jzimme14/ESP32-C3-custom-test-board/ASCKCF00-AP5R5010402/3D/ASCKCF00-AP5R5010402.stp

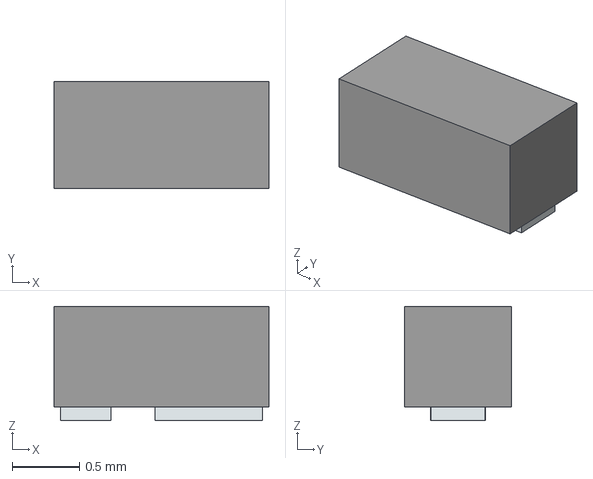
[picture p1: CAD file, 2024-05-04]
ASCKCF00-AP5R5010402/3D/ASCKCF00-AP5R5010402.stp
1.60 x 0.8 x 0.85 mm
Pins
