jzimme14/ESP32-C3-custom-test-board/BME280/3D/BME280.stp

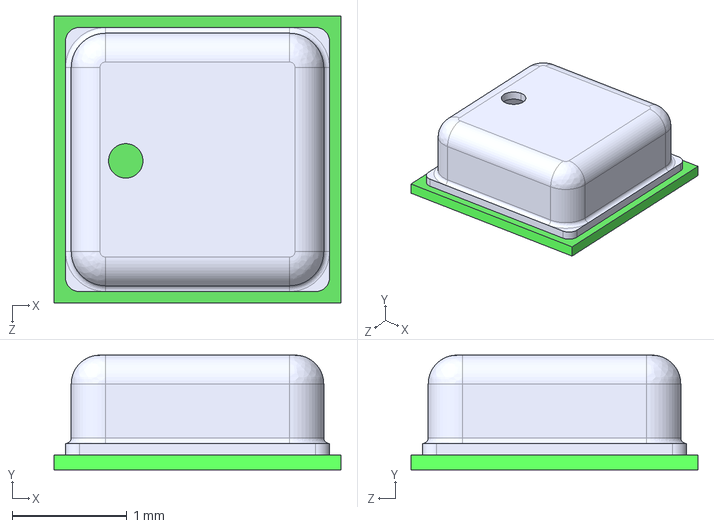
[picture p2: CAD file, 2024-05-04]
BME280/3D/BME280.stp
2.50 x 1.00 x 2.50 mm
