jzimme14/ESP32-C3-custom-test-board/ESP32-C3/3D/ESP32-C3.stp

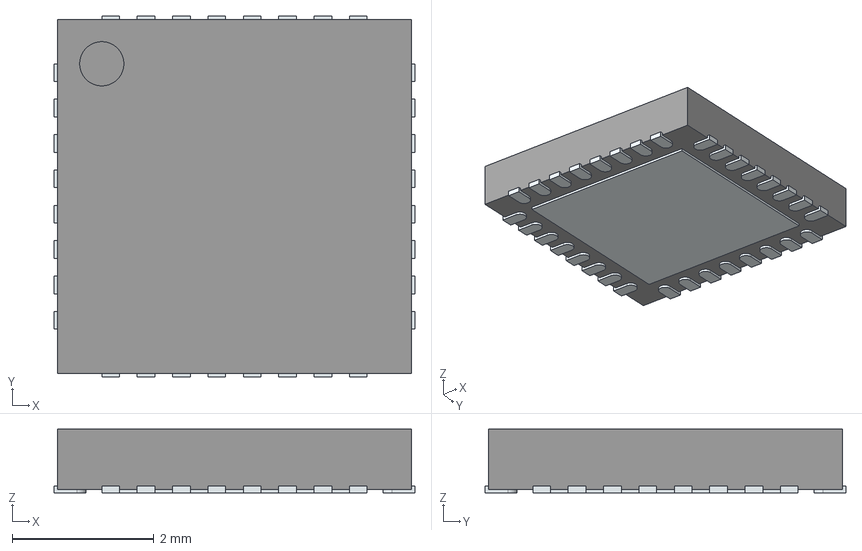
[picture p3: CAD file, 2024-05-03]
ESP32-C3/3D/ESP32-C3.stp
5.10 x 5.10 x 0.9 mm
ThermalPin
PinsArrayLR
PinsArrayTB
