jzimme14/ESP32-C3-custom-test-board/GD25Q16CTEGR/3D/GD25Q16CTEGR.stp

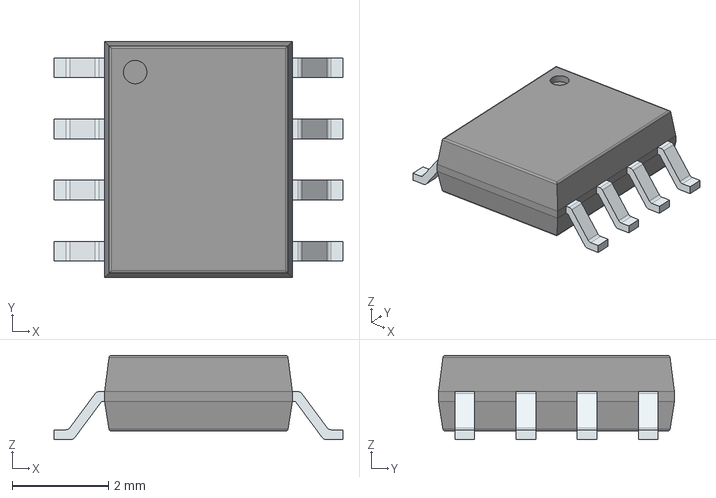
[picture p4: CAD file, 2024-05-03]
GD25Q16CTEGR/3D/GD25Q16CTEGR.stp
6.00 x 4.90 x 1.75 mm
PinsArrayLR
