jzimme14/ESP32-C3-custom-test-board/GSB1C41110SSHR/3D/GSB1C41110SSHR.stp

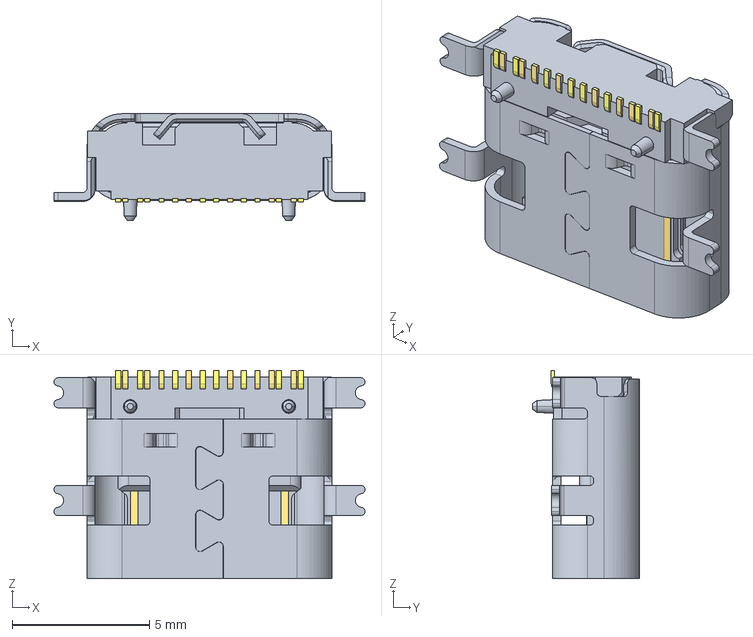
[picture p5: CAD file, 2024-05-03]
GSB1C41110SSHR/3D/GSB1C41110SSHR.stp
11.3 x 3.89 x 7.60 mm
