jzimme14/ESP32-C3-custom-test-board/SMD_IC_SY8089AAAC/3D/SMD_IC_SY8089AAAC.stp

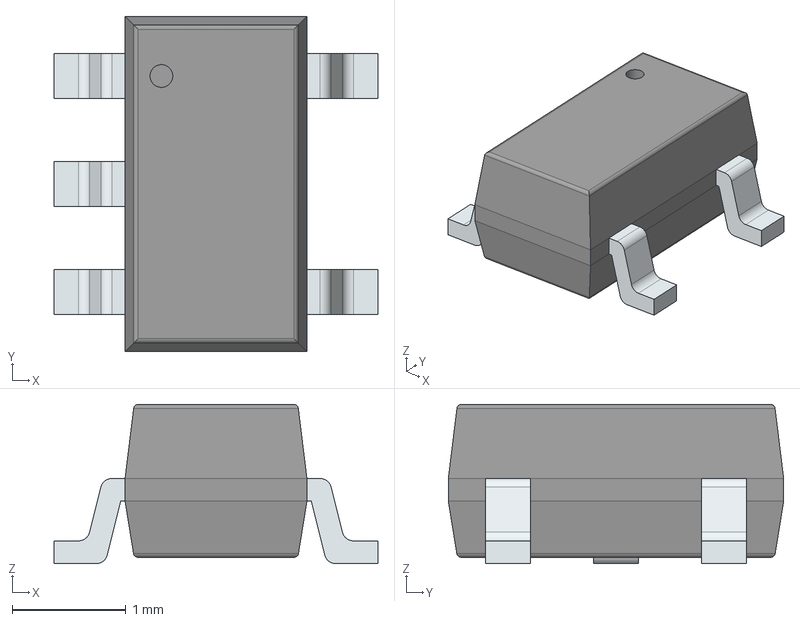
[picture p6: CAD file, 2024-05-07]
SMD_IC_SY8089AAAC/3D/SMD_IC_SY8089AAAC.stp
2.85 x 2.95 x 1.40 mm
PinsArrayL
PinsArrayR
