jzimme14/ESP32-C3-custom-test-board/SPX3819M5-L-3-3_TR/3D/SPX3819M5-L-3-3_TR.stp

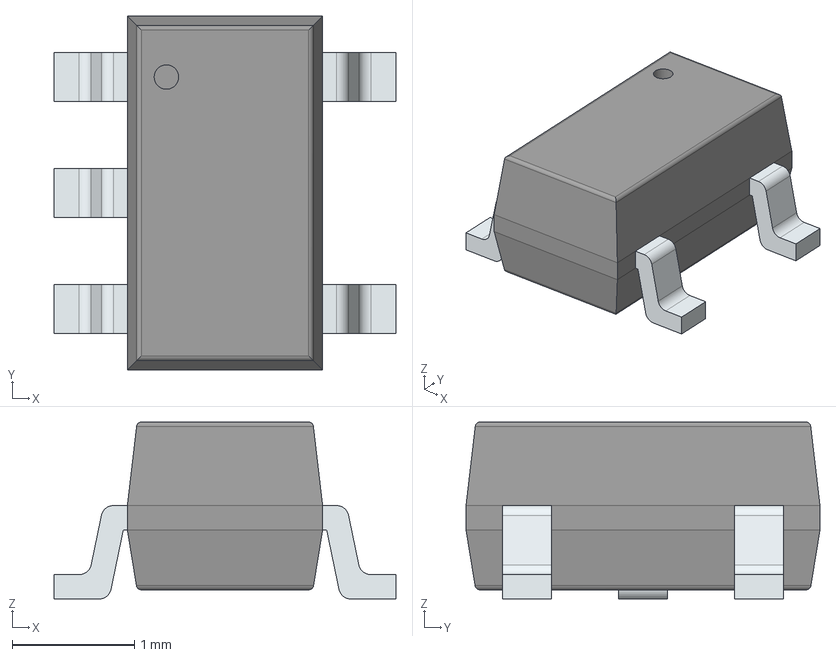
[picture p7: CAD file, 2024-05-03]
SPX3819M5-L-3-3_TR/3D/SPX3819M5-L-3-3_TR.stp
2.80 x 2.90 x 1.45 mm
PinsArrayL
PinsArrayR
