jzimme14/ESP32-C3-custom-test-board/434781025816/3D/434781025816.stp

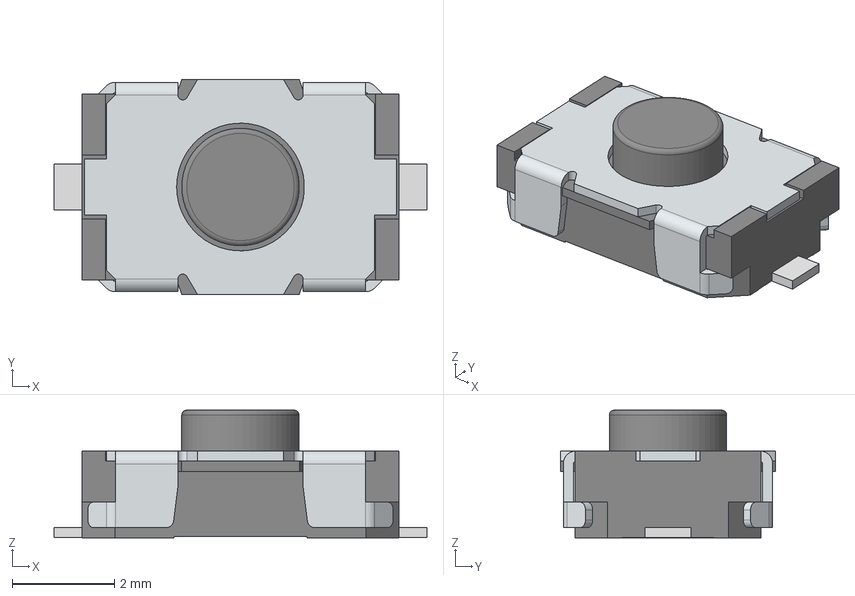
[picture p8: CAD file, 2024-05-04]
434781025816/3D/434781025816.stp
7.30 x 4.20 x 2.50 mm
Base_oa_0
Cover
Pins
