jzimme14/ESP32-C3-custom-test-board/830108208709/3D/830108208709.stp

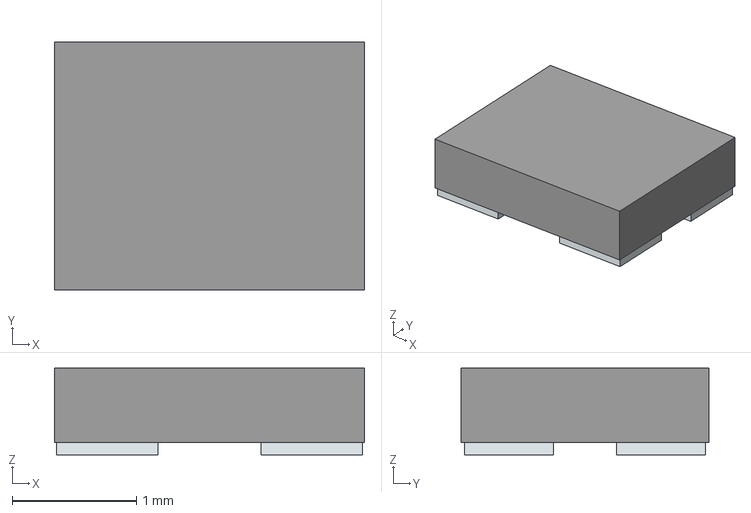
[picture p9: CAD file, 2024-05-03]
830108208709/3D/830108208709.stp
2.50 x 2.00 x 0.7 mm
Pins
