jzimme14/ESP32-C3-custom-test-board/(list of files, cad)

Other CAD files:
USBLC6-2SC6/3D/USBLC6-2SC6.stp
434781025816/Allegro/434781025816.psm
434781025816/DEHDL/434781025816/chips/chips.prt
830108208709/Allegro/830108208709.psm
830108208709/DEHDL/830108208709/chips/chips.prt
ASCKCF00-AP5R5010402/Allegro/asckcf00ap5r5010402.psm
ASCKCF00-AP5R5010402/DEHDL/asckcf00_ap5r5010402/chips/chips.prt
BME280/Allegro/bme280.psm
BME280/DEHDL/bme280/chips/chips.prt
ESP32-C3/Allegro/qfn50p500x500x90-33n-d.psm
ESP32-C3/DEHDL/esp32_c3/chips/chips.prt
GD25Q16CTEGR/Allegro/soic127p600x175-8n.psm
GD25Q16CTEGR/DEHDL/gd25q16ctegr/chips/chips.prt
GSB1C41110SSHR/Allegro/gsb1c41110sshr.psm
GSB1C41110SSHR/DEHDL/gsb1c41110sshr/chips/chips.prt
SMD_IC_SY8089AAAC/Allegro/sot95p285x140-5n.psm
SMD_IC_SY8089AAAC/DEHDL/smd_ic_sy8089aaac/chips/chips.prt
SPX3819M5-L-3-3_TR/Allegro/sot95p280x145-5n.psm
SPX3819M5-L-3-3_TR/DEHDL/spx3819m5_l_3_3_tr/chips/chips.prt
USBLC6-2SC6/Allegro/sot95p280x145-6n.psm
USBLC6-2SC6/DEHDL/usblc6_2sc6/chips/chips.prt
