jzimme14/ESP32-C3-custom-test-board/esp32_c3_custom_board/esp32_c3_custom_board.kicad_pcb

## KiCad design esp32_c3_custom_board/esp32_c3_custom_board.kicad_pcb (2024-06-27)

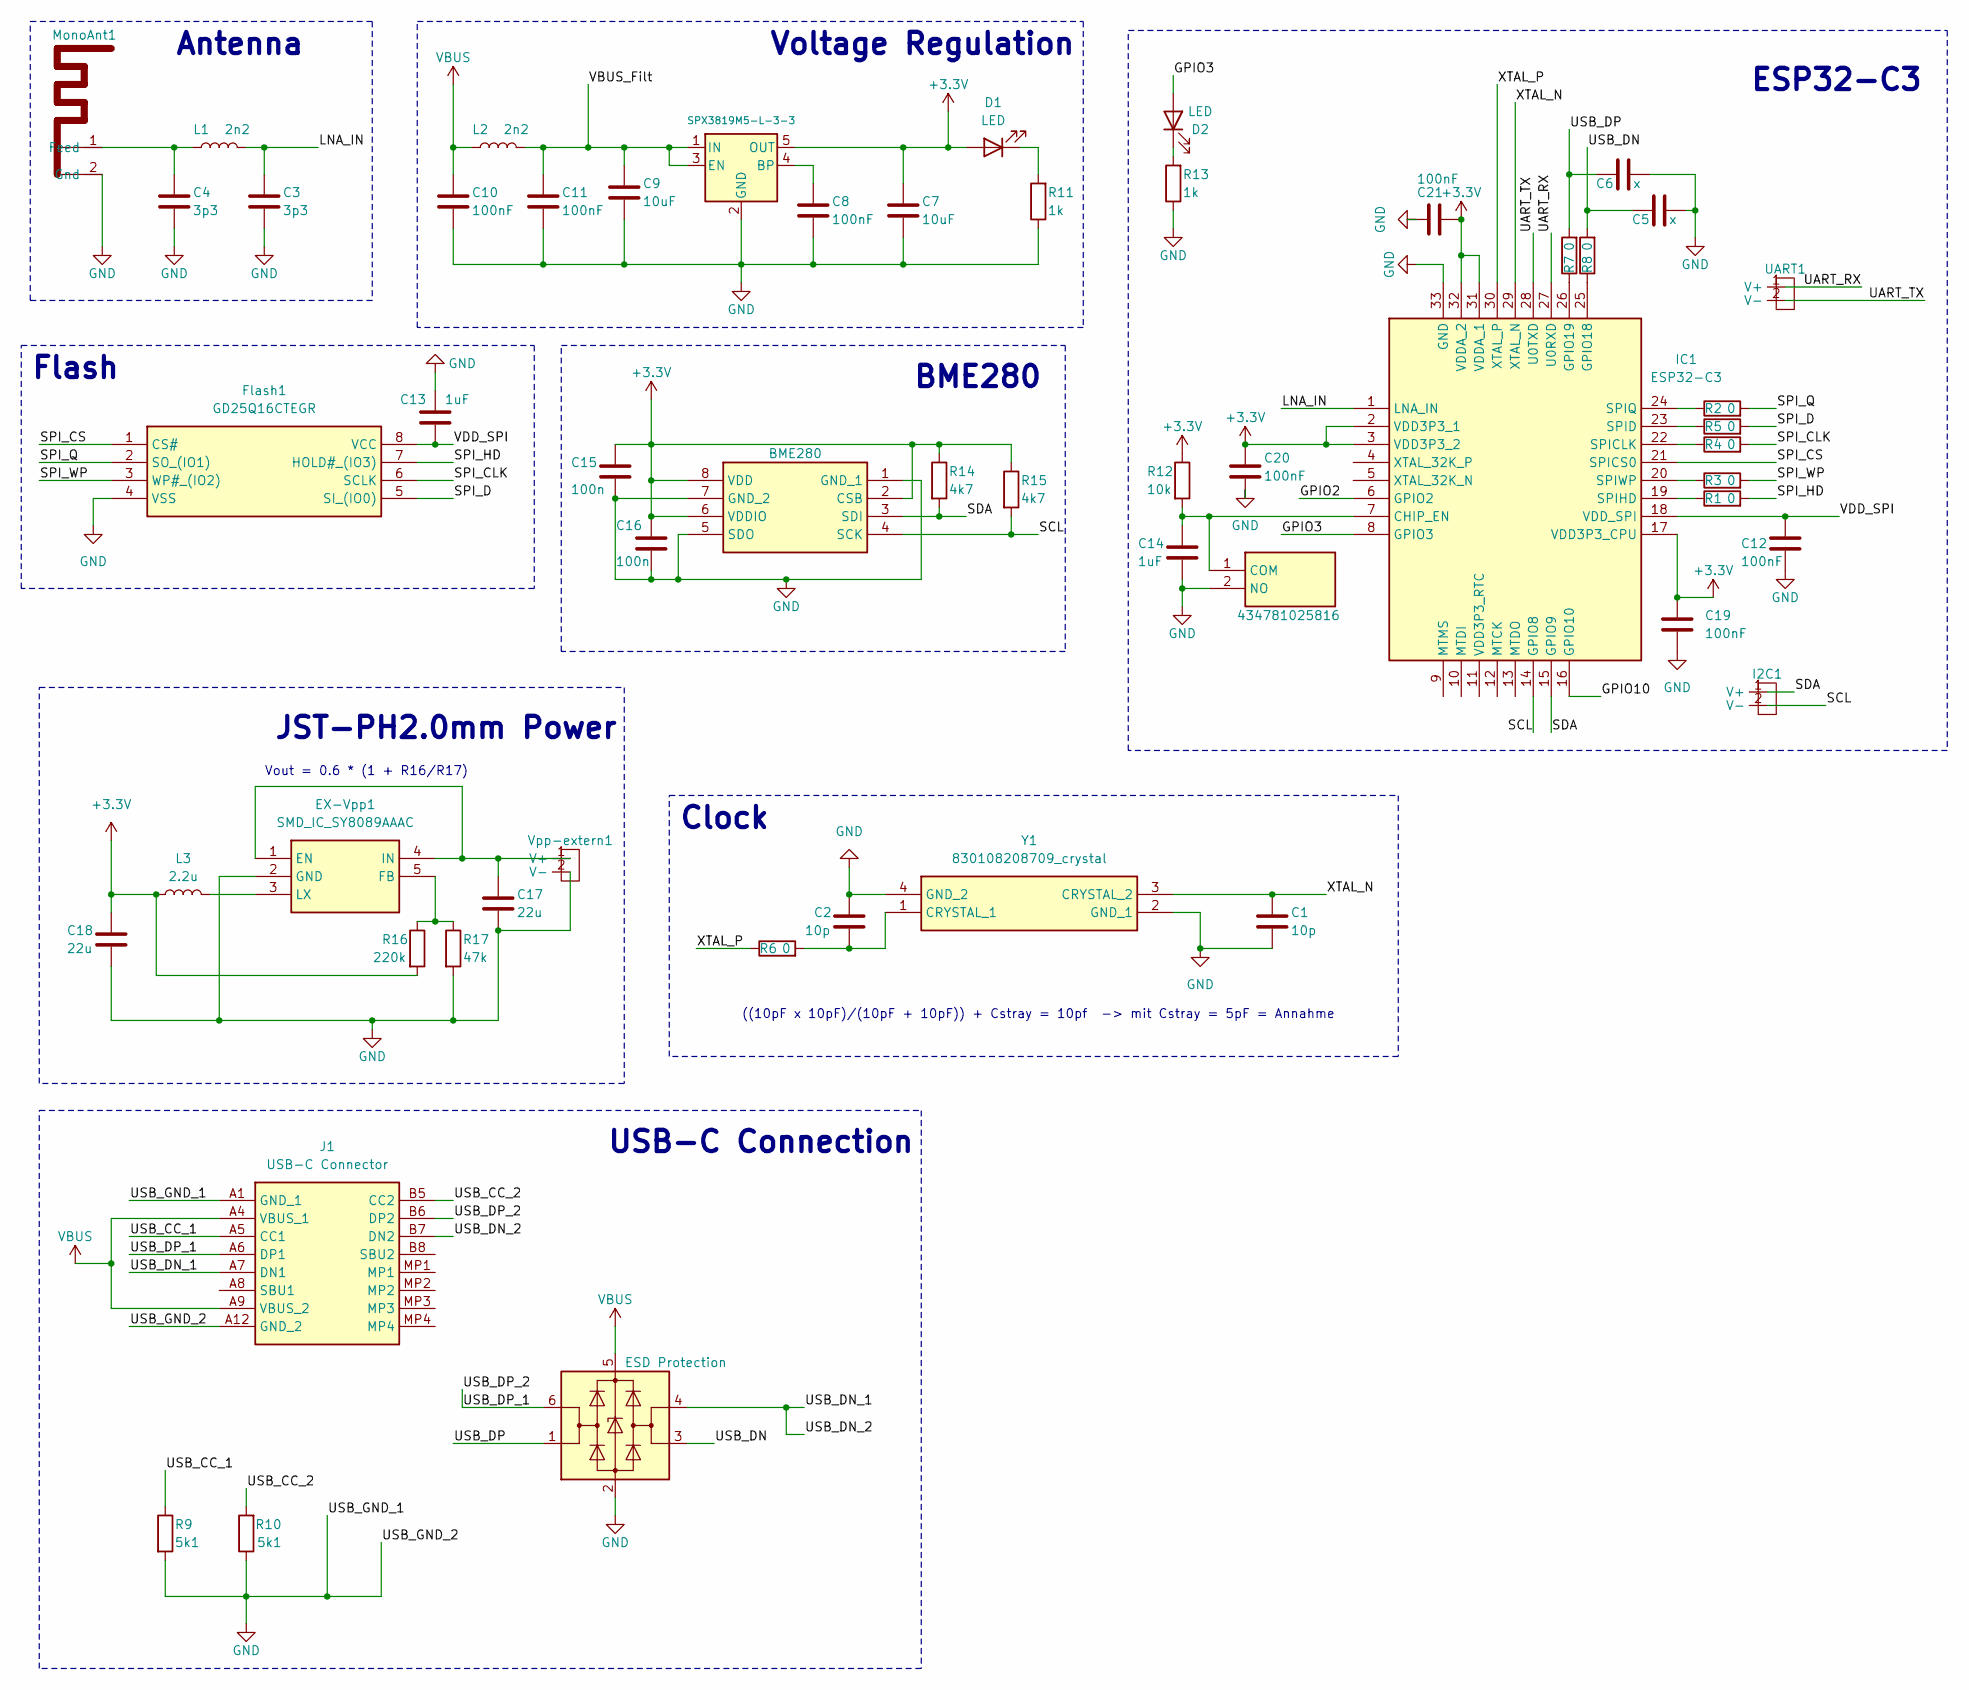
[picture p10: schematic esp32_c3_custom_board.kicad_sch]

Parts:
C1, C2: 10p; C_0402_1005Metric_Pad0.74x0.62mm_HandSolder
C3, C4: 3p3; C_0603_1608Metric_Pad1.08x0.95mm_HandSolder
C5, C6: x; C_0402_1005Metric_Pad0.74x0.62mm_HandSolder
C7, C9: 10uF; C_0603_1608Metric_Pad1.08x0.95mm_HandSolder
C8, C10, C11, C12, C19, C20, C21: 100nF; C_0603_1608Metric_Pad1.08x0.95mm_HandSolder
C13: 1uF; C_0402_1005Metric_Pad0.74x0.62mm_HandSolder
C14: 1uF; C_0603_1608Metric_Pad1.08x0.95mm_HandSolder
C15, C16: 100n; C_0402_1005Metric_Pad0.74x0.62mm_HandSolder
C17, C18: 22u; C_0805_2012Metric_Pad1.18x1.45mm_HandSolder
D1, D2: LED; ASCKCF00AP5R5010402
ESD1: ESD Protection; SOT95P280X145-6N
EX-Vpp1: SMD_IC_SY8089AAAC; SOT95P285X140-5N; Mouser Part Number 909-SMDICSY8089AAAC
Flash1: GD25Q16CTEGR; SOIC127P600X175-8N; Mouser Part Number 363-GD25Q16CTEGR
HM1: BME280; Mouser Part Number 262-BME280
I2C1: JST-PH2.0mm
IC1: ESP32-C3; QFN50P500X500X90-33N-D; Mouser Part Number 356-ESP32-C3
J1: USB-C Connector; GSB1C41110SSHR; Manufacturer_Part_Number GSB1C41110SSHR
L1, L2: 2n2; L_0603_1608Metric_Pad1.05x0.95mm_HandSolder
L3: 2.2u; L_0603_1608Metric_Pad1.05x0.95mm_HandSolder
MonoAnt1: Texas_SWRA117D_2.4GHz_Right
R1, R2, R3, R4, R5, R6, R7, R8: 0; R_0402_1005Metric_Pad0.72x0.64mm_HandSolder
R9, R10: 5k1; R_0402_1005Metric_Pad0.72x0.64mm_HandSolder
R11, R13: 1k; R_0603_1608Metric_Pad0.98x0.95mm_HandSolder
R12: 10k; R_0603_1608Metric_Pad0.98x0.95mm_HandSolder
R14, R15: 4k7; R_0402_1005Metric_Pad0.72x0.64mm_HandSolder
R16: 220k; R_0603_1608Metric_Pad0.98x0.95mm_HandSolder
R17: 47k; R_0603_1608Metric_Pad0.98x0.95mm_HandSolder
S1: 434781025816; Mouser Part Number 710-434781025816
UART1: JST-PH2.0mm
USB-Vpp1: SPX3819M5-L-3-3; SOT95P280X145-5N
Vpp-extern1: JST-PH2.0mm
Y1: 830108208709_crystal; 830108208709; Mouser Part Number 710-830108208709

Connections:
+3.3V: C7.1, C15.1, C16.1, C18.1, C19.1, C20.1, C21.1, D1.2 (A), HM1.2 (CSB), HM1.6 (VDDIO), HM1.8 (VDD), IC1.2 (VDD3P3_1), IC1.3 (VDD3P3_2), IC1.17 (VDD3P3_CPU), IC1.31 (VDDA_1), IC1.32 (VDDA_2), L3.1, R12.1, R14.1, R15.1, R16.2, USB-Vpp1.5 (OUT)
/GPIO2: IC1.6 (GPIO2)
/GPIO3: D2.2 (A), IC1.8 (GPIO3)
/GPIO10: IC1.16 (GPIO10)
/LNA_IN: C3.1, IC1.1 (LNA_IN), L1.2
/SCL: HM1.4 (SCK), I2C1.2 (V-), IC1.14 (GPIO8), R15.2
/SDA: HM1.3 (SDI), I2C1.1 (V+), IC1.15 (GPIO9), R14.2
/SPI_CLK: Flash1.6 (SCLK), R4.2
/SPI_CS: Flash1.1 (CS#), IC1.21 (SPICS0)
/SPI_D: Flash1.5 (SI_(IO0)), R5.2
/SPI_HD: Flash1.7 (HOLD#_(IO3)), R1.2
/SPI_Q: Flash1.2 (SO_(IO1)), R2.2
/SPI_WP: Flash1.3 (WP#_(IO2)), R3.2
/UART_RX: IC1.27 (U0RXD), UART1.1 (V+)
/UART_TX: IC1.28 (U0TXD), UART1.2 (V-)
/USB_CC_1: J1.A5 (CC1), R9.1
/USB_CC_2: J1.B5 (CC2), R10.2
/USB_DN: C5.1, ESD1.3 (I/O2), R8.2
/USB_DN_1: ESD1.4 (I/O2), J1.A7 (DN1), J1.B7 (DN2)
/USB_DP: C6.1, ESD1.1 (I/O1), R7.2
/USB_DP_1: ESD1.6 (I/O1), J1.A6 (DP1), J1.B6 (DP2)
/VBUS_Filt: C9.1, C11.1, L2.2, USB-Vpp1.1 (IN), USB-Vpp1.3 (EN)
/VDD_SPI: C12.1, C13.2, Flash1.8 (VCC), IC1.18 (VDD_SPI)
/XTAL_N: C1.1, IC1.29 (XTAL_N), Y1.3 (CRYSTAL_2)
/XTAL_P: IC1.30 (XTAL_P), R6.1
GND: C1.2, C2.1, C3.2, C4.2, C5.2, C6.2, C7.2, C8.2, C9.2, C10.2, C11.2, C12.2, C13.1, C14.2, C15.2, C16.2, C17.2, C18.2, C19.2, C20.2, C21.2, ESD1.2 (GND), EX-Vpp1.2 (GND), Flash1.4 (VSS), HM1.1 (GND_1), HM1.5 (SDO), HM1.7 (GND_2), IC1.33 (GND), J1.A1 (GND_1), J1.A12 (GND_2), MonoAnt1.2 (Gnd), R9.2, R10.1, R11.1, R13.1, R17.2, S1.2 (NO), USB-Vpp1.2 (GND), Vpp-extern1.2 (V-), Y1.2 (GND_1), Y1.4 (GND_2); also elsewhere on the board
unnamed: D1.1 (K), R11.2
unnamed: D2.1 (K), R13.2
unnamed 28: C17.1, EX-Vpp1.1 (EN), EX-Vpp1.4 (IN), Vpp-extern1.1 (V+); also elsewhere on the board
unnamed: EX-Vpp1.5 (FB), R16.1, R17.1
unnamed: EX-Vpp1.3 (LX), L3.2
unnamed: C14.1, IC1.7 (CHIP_EN), R12.2, S1.1 (COM)
unnamed: IC1.25 (GPIO18), R8.1
unnamed: IC1.26 (GPIO19), R7.1
unnamed: IC1.22 (SPICLK), R4.1
unnamed: IC1.23 (SPID), R5.1
unnamed: IC1.19 (SPIHD), R1.1
unnamed: IC1.24 (SPIQ), R2.1
unnamed: IC1.20 (SPIWP), R3.1
unnamed: C4.1, L1.1, MonoAnt1.1 (Feed)
unnamed: C8.1, USB-Vpp1.4 (BP)
unnamed: C2.2, R6.2, Y1.1 (CRYSTAL_1)
VBUS: C10.1, ESD1.5 (VBUS), J1.A4 (VBUS_1), J1.A9 (VBUS_2), L2.1

Notes on the sheet:
Clock
USB-C Connection
JST-PH2.0mm Power
ESP32-C3
Voltage Regulation
((10pF x 10pF)/(10pF + 10pF)) + Cstray = 10pf -> mit Cstray = 5pF = Annahme
Flash
Antenna
Vout = 0.6 * (1 + R16/R17)
BME280

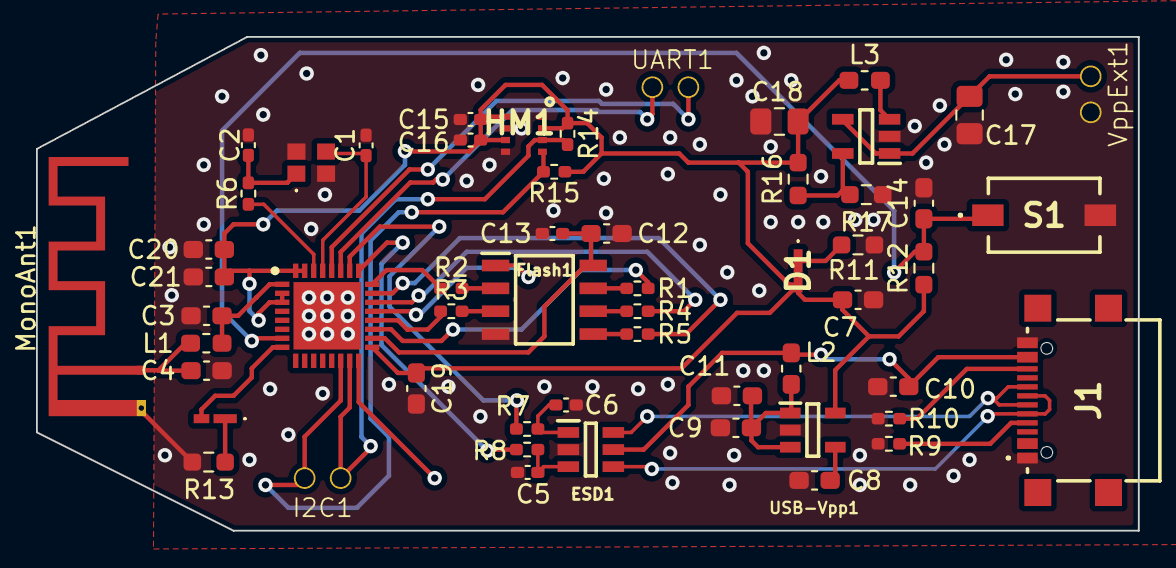
[picture p11: board esp32_c3_custom_board.kicad_pcb from above]

Board: 2 copper layers, 61.2 x 27.4 mm, 56 parts (0 on the bottom side), 41 nets.

Other parts of the board:
VppExt1: JST-PH2.0mm

Their connections:
GND: VppExt1.2 (V-); also elsewhere on the board
unnamed 28: VppExt1.1 (V+); also elsewhere on the board
