jzimme14/ESP32-C3-custom-test-board/(commit log)

2024-06-27 final design yallahhh
    [esp32_c3_custom_board.kicad_pcb, esp32_c3_custom_board.kicad_sch]
2024-06-27 gerber files generated
    [esp32_c3_custom_board-B_Cu.gbl, esp32_c3_custom_board-B_Cu.gbr, esp32_c3_custom_board-B_Mask.gbr, esp32_c3_custom_board-B_Mask.gbs, esp32_c3_custom_board-B_Paste.gbp, esp32_c3_custom_board-B_Paste.gbr, esp32_c3_custom_board-B_Silkscreen.gbo, esp32_c3_custom_board-B_Silkscreen.gbr]
